embelon/SKY130_OpAmp/01_IdeaDesign/opamp_cascode_sym.png

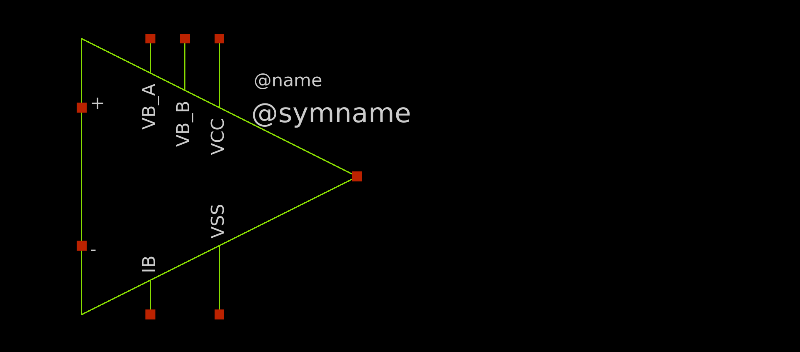
01_IdeaDesign/opamp_cascode_sym.png
