embelon/SKY130_OpAmp/01_IdeaDesign/opamp_cascode_sch.pdf

# /home/zwierzak/projects/SKY130_OpAmp/01_IdeaDesign/opamp_cascode.sch

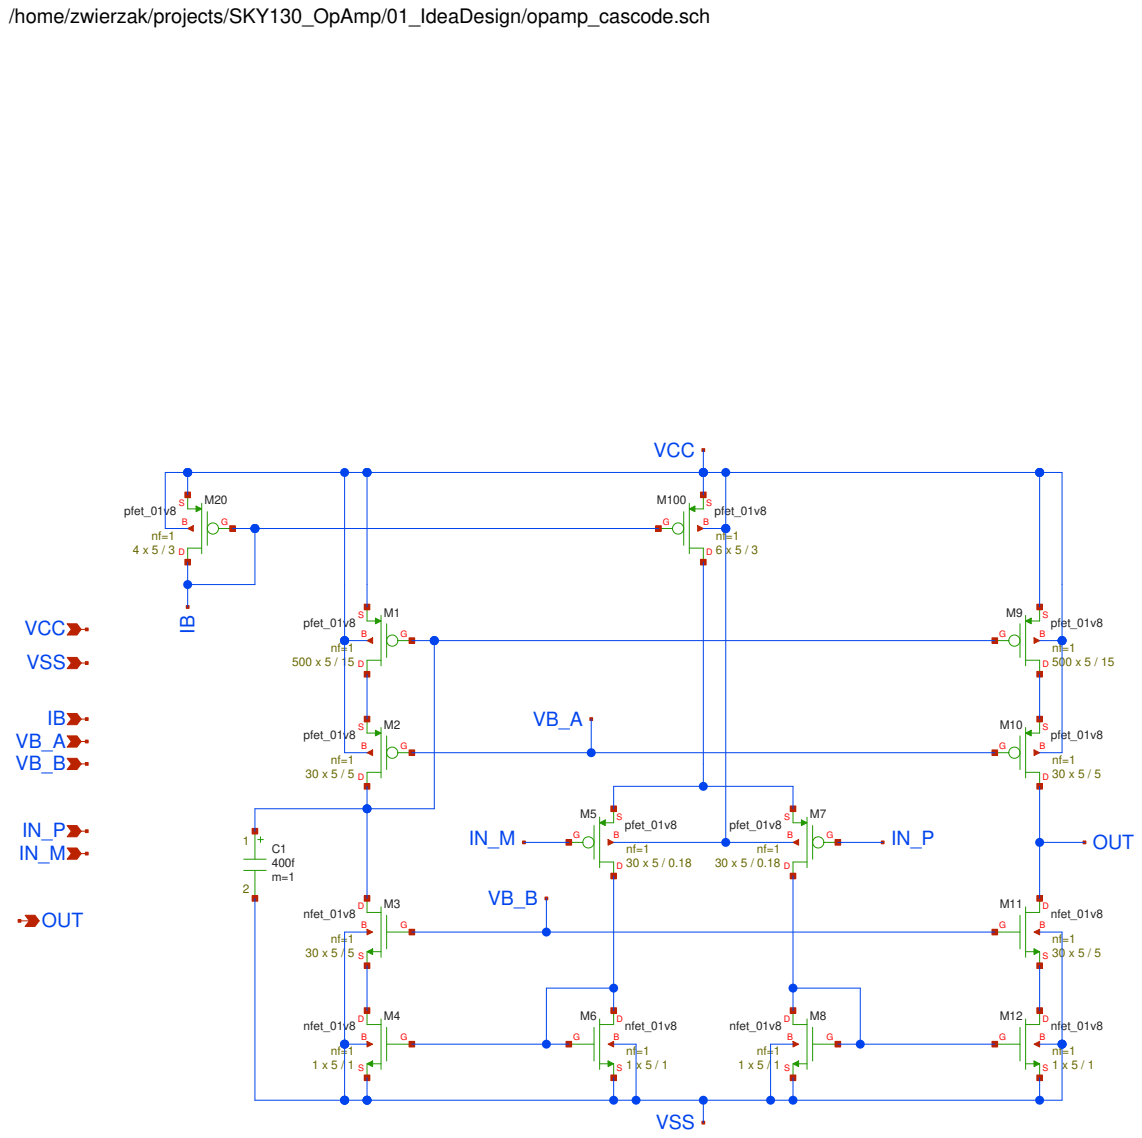
[picture p2: page 1]
VCC; VSS; IN_PIN_M; OUT; pfet_01v8; nfet_01v8
