embelon/SKY130_OpAmp/03_Layout/opamp_cascode_sch.pdf

# /home/zwierzak/projects/SKY130_OpAmp/03_Layout/opamp_cascode.sch

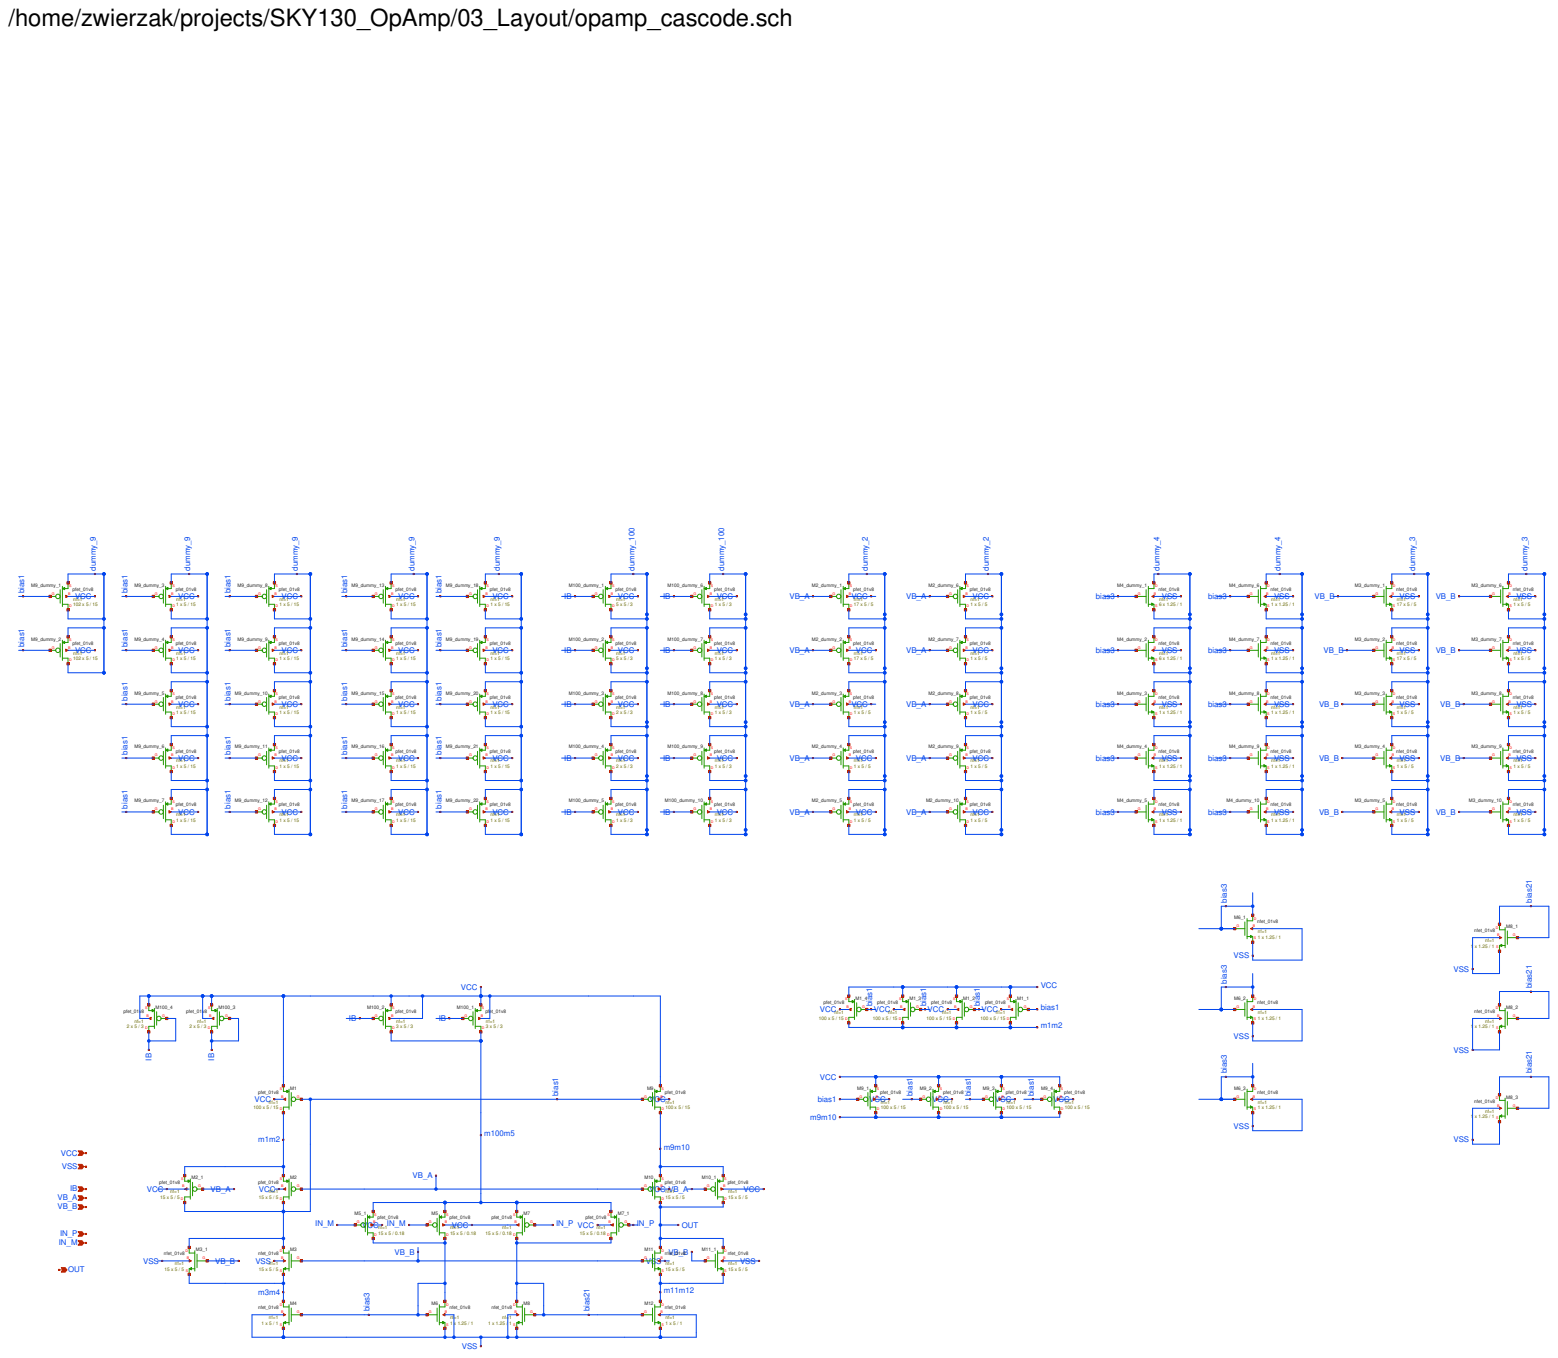
[picture p3: page 1]
VCC; VSS; IN_PIN_M; OUT; bias3; bias21; bias1; VB_AVB_A; bias1bias1; bias1bias1bias1bias1bias1; dummy_9; dummy_100; dummy_2; dummy_4; dummy_3; VSSVSS; VCCVCCVCCVCC; VCCVCC; pfet_01v8; nfet_01v8; M9_dummy_1; M9_dummy_2; M9_dummy_3; M9_dummy_4; M9_dummy_5; M9_dummy_6; M9_dummy_7; M9_dummy_8; M9_dummy_9; M9_dummy_10; M9_dummy_11; M9_dummy_12; M100_dummy_1; M100_dummy_2; M100_dummy_3; M100_dummy_4; M100_dummy_5; M100_dummy_6; M100_dummy_7; M100_dummy_8; M100_dummy_9; M100_dummy_10; M2_dummy_1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
