embelon/SKY130_OpAmp/06_ParasiticsSim/opamp_cascode.spice

* NGSPICE file created from opamp_cascode.ext - technology: sky130A

.subckt opamp_cascode IN_P IN_M VCC VSS OUT VB_A VB_B IB
X0 m9m10.t499 bias1.t0 VCC.t1023 VCC.t121 sky130_fd_pr__pfet_01v8 ad=0 pd=0 as=0 ps=0 w=5 l=15
**devattr s=58000,2116 d=58000,2116
X1 VCC.t1022 bias1.t1 m1m2.t499 VCC.t95 sky130_fd_pr__pfet_01v8 ad=0 pd=0 as=0 ps=0 w=5 l=15
**devattr s=58000,2116 d=58000,2116
X2 m3m4.t29 VB_B.t0 bias1 VSS.t4 sky130_fd_pr__nfet_01v8 ad=0 pd=0 as=1.45 ps=10.6 w=5 l=5
**devattr s=58000,2116 d=58000,2116
X3 dummy_9.t447 bias1.t2 dummy_9.t446 VCC.t33 sky130_fd_pr__pfet_01v8 ad=0 pd=0 as=0 ps=0 w=5 l=15
**devattr d=58000,2116
X4 VCC.t1021 bias1.t3 m1m2.t498 VCC.t17 sky130_fd_pr__pfet_01v8 ad=0 pd=0 as=0 ps=0 w=5 l=15
**devattr s=58000,2116 d=58000,2116
X5 dummy_9.t445 bias1.t4 dummy_9.t444 VCC.t30 sky130_fd_pr__pfet_01v8 ad=0 pd=0 as=0 ps=0 w=5 l=15
**devattr d=58000,2116
X6 VCC.t1020 bias1.t5 m1m2.t497 VCC.t95 sky130_fd_pr__pfet_01v8 ad=0 pd=0 as=0 ps=0 w=5 l=15
**devattr s=58000,2116 d=58000,2116
X7 m9m10.t498 bias1.t6 VCC.t1019 VCC.t11 sky130_fd_pr__pfet_01v8 ad=0 pd=0 as=0 ps=0 w=5 l=15
**devattr s=58000,2116 d=58000,2116
X8 dummy_9.t443 bias1.t7 dummy_9.t442 VCC.t33 sky130_fd_pr__pfet_01v8 ad=0 pd=0 as=0 ps=0 w=5 l=15
**devattr d=58000,2116
X9 m9m10.t497 bias1.t8 VCC.t1018 VCC.t21 sky130_fd_pr__pfet_01v8 ad=0 pd=0 as=0 ps=0 w=5 l=15
**devattr s=58000,2116 d=58000,2116
X10 dummy_4.t39 bias3.t38 dummy_4.t38 VSS.t6 sky130_fd_pr__nfet_01v8 ad=0 pd=0 as=0 ps=0 w=1.25 l=1
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
**devattr d=58000,2116
X225 dummy_2.t75 VB_A.t14 dummy_2.t74 VCC.t1043 sky130_fd_pr__pfet_01v8 ad=0 pd=0 as=0 ps=0 w=5 l=5
**devattr d=58000,2116
X226 m9m10.t416 bias1.t186 VCC.t874 VCC.t9 sky130_fd_pr__pfet_01v8 ad=0 pd=0 as=0 ps=0 w=5 l=15
**devattr s=58000,2116 d=58000,2116
X227 m9m10.t415 bias1.t187 VCC.t873 VCC.t21 sky130_fd_pr__pfet_01v8 ad=0 pd=0 as=0 ps=0 w=5 l=15
**devattr s=58000,2116 d=58000,2116
X228 OUT.t54 VB_A.t15 m9m10.t514 VCC.t1041 sky130_fd_pr__pfet_01v8 ad=0 pd=0 as=0 ps=0 w=5 l=5
**devattr s=58000,2116 d=58000,2116
X229 VCC.t872 bias1.t188 m1m2.t433 VCC.t44 sky130_fd_pr__pfet_01v8 ad=0 pd=0 as=0 ps=0 w=5 l=15
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
