embelon/SKY130_OpAmp/06_ParasiticsSim/simulation/opamp_cascode_op_power.spice

** sch_path: ../opamp_cascode_op_power.sch
**.subckt opamp_cascode_op_power
C1 out GND 1p m=1
I0 IBIAS GND 45u
x1 Vp Vn VCC GND out VB_A VB_B IBIAS opamp_cascode
**** begin user architecture code


Vsupply VCC GND 1.8
VbiasA VB_A GND 0.2
VbiasB VB_B GND 1.1
Vpos Vp GND 0.9
Vneg Vn GND 0.9
.include ../opamp_cascode.spice
.control
  define Power(x,y) -(x*y)
  save all
  op
  print Power(v(VCC), Vsupply#branch)
.endc



.param mc_mm_switch=1
.param mc_pr_switch=0
.include ~/.volare/sky130A/libs.tech/ngspice/corners/tt.spice
.include ~/.volare/sky130A/libs.tech/ngspice/r+c/res_typical__cap_typical.spice
.include ~/.volare/sky130A/libs.tech/ngspice/r+c/res_typical__cap_typical__lin.spice
.include ~/.volare/sky130A/libs.tech/ngspice/corners/tt/specialized_cells.spice

**** end user architecture code
**.ends
.GLOBAL GND
.end
