embelon/SKY130_OpAmp/(commit log)

2023-04-12 Adding files for version w/out LVT P-channel transistors in diff pair
    [opamp_noplvt.sch, test_ac_noplvt.sch, test_dc_response_noplvt.sch]
2023-05-22 Removed version with SVT PMOS transistors.
    [opamp_noplvt.sch, test_ac_noplvt.sch, test_dc_response_noplvt.sch]
2023-05-22 Changed all PMOS and NMOS transistors from LVT to SVT.
    [opamp.sch]
2023-05-22 Removed old AC open loop simulation and get correct one working (Ochoa Z-method)
    [opamp_test_ac.sch, test_ac.sch]
2023-05-22 Added (Folded) Cascode OpAmp and it's symbol.
    [opamp_cascode.sch]
2023-05-22 Added AC open look simulation for cascode OpAmp (acc. Ochoa Z-method).
    [opamp_cascode_test_ac.sch]
2023-05-23 Set biasing voltages to something better than VSS and VCC.
    [opamp_cascode.sch, opamp_cascode_test_ac.sch]
2023-05-23 Added simulation for dc response for cascode OpAmp.
    [opamp_cascode_dc_response.sch]
2023-05-31 Renamed components.
    [opamp_cascode.sch]
2023-05-31 Changed simulation settings to make ngspice plot results.
    [opamp_cascode_dc_response.sch]
2023-06-15 Changed span to +/-5mV for dc response simulation.
    [opamp_cascode_dc_response.sch]
2023-06-15 Removed unused labels.
    [opamp_cascode.sch]
2023-06-15 Added operation point simulation to check vds voltages across transistors.
    [opamp_cascode_op_point.sch]
2023-06-16 Adjusted transistors W/L to get better operation point.
    [opamp_cascode.sch]
2023-06-16 Proper way of checking max open loop gain.
    [opamp_cascode_dc_sweep_10mV.sch]
2023-06-16 Removed old way of checking max open loop gain.
    [opamp_cascode_dc_response.sch]
2023-06-16 Removing old files and adding view of current state of max open loop gain.
2023-06-16 Renamed file.
    [opamp_cascode_dc_max_gain.sch]
2023-06-16 Removed old 5/6T OpAmp files.
    [opamp.sch, opamp_test_ac.sch, test.sch, test_bias.sch]
2023-06-22 Updated transistors parameters.
    [opamp_cascode.sch, opamp_cascode_dc_max_gain.sch, opamp_cascode_test_ac.sch]
2023-06-23 Updated parameters. Max gain now at 18k, phase margin >60deg.
    [opamp_cascode.sch, opamp_cascode_op_point.sch]
2023-06-23 Renamed AC test to indicate method name.
    [opamp_cascode_ac_ochoa.sch]
2023-06-23 Made bias voltages and current accessible outside OpAmp.
    [opamp_cascode.sch, opamp_cascode_ac_ochoa.sch]
2023-06-26 Updated DC max gain and operation point simulations after making voltage and current biases accessible from outside of model.
    [opamp_cascode_dc_max_gain.sch, opamp_cascode_op_point.sch]
2023-06-26 Added open loop simulation.
    [opamp_cascode_ac_openloop.sch]
2023-06-27 Fixed inverted polarity of inputs.
    [opamp_cascode.sch]
2023-06-27 Added cimulation for bandwidth calculation.
    [opamp_cascode_ac_bandwidth.sch]
2023-06-27 Added measuring max openloop gain.
    [opamp_cascode_dc_max_gain.sch]
2023-06-30 Changed Vbias_B to 1.0V - max gain is now almost 32k.
    [opamp_cascode_ac_bandwidth.sch, opamp_cascode_ac_ochoa.sch, opamp_cascode_dc_max_gain.sch, opamp_cascode_op_point.sch]
2023-06-30 Updated simulations.
    [opamp_cascode_ac_bandwidth.sch, opamp_cascode_ac_openloop.sch, opamp_cascode_dc_max_gain.sch]
2023-07-04 Improved AC openloop, but still worse than with Ochoa Z-method.
    [opamp_cascode_ac_ochoa.sch, opamp_cascode_ac_openloop.sch]
2023-07-04 Added Id to op analysis.
    [opamp_cascode_op_point.sch]
2023-07-10 21M 63 79.8k v/v (#1)
    * 24.2M 75 63k v/v
    * 21M 66 79.8k v/v
    [opamp_cascode.sch, opamp_cascode_ac_bandwidth.sch, opamp_cascode_ac_ochoa.sch, opamp_cascode_dc_max_gain.sch, opamp_cascode_op_point.sch, opamp_cascode_test.sch]
2023-07-17 Modified testbenches to use in-code specified voltage sources instead of instantiated.
    [opamp_cascode_ac_bandwidth.sch, opamp_cascode_ac_ochoa.sch, opamp_cascode_ac_openloop.sch, opamp_cascode_dc_max_gain.sch, opamp_cascode_op_point.sch]
2023-07-17 Added tb to measure input referred noise.
    [opamp_cascode_ac_noise.sch]
2023-07-17 Added tb to measure PSRR.
    [opamp_cascode_ac_psrr.sch]
2023-07-17 Added tb to measure static power.
    [opamp_cascode_op_power.sch]
2023-08-21 Decreased Ibias to 4.5u
    [opamp_cascode_ac_openloop.sch]
2023-08-21 Removed unnecessary show command
    [opamp_cascode_op_power.sch]
2023-08-21 Added Monte CArlo simulation for dc max gain
    [opamp_cascode_dc_max_gain_mc.sch]
2023-09-06 Changed parameters in current mirror to move to higher value of Ibias to stay away from leakage current on IO pad.
    [opamp_cascode.sch]
2023-09-06 Adjusted Ibias to 45uA. Changed name of result SVG file.
    [opamp_cascode_dc_max_gain.sch]
2023-09-06 Adjusted Ibias to 45uA. Changed name of result SVG file and names of txt results files.
    [opamp_cascode_dc_max_gain_mc.sch]
2023-09-18 Increased value of Ibias after changing current mirror transistors.
    [opamp_cascode_ac_bandwidth.sch, opamp_cascode_ac_noise.sch, opamp_cascode_ac_ochoa.sch, opamp_cascode_ac_openloop.sch, opamp_cascode_ac_psrr.sch, opamp_cascode_op_power.sch]
2023-09-18 Decreased precision to speed up simulation.
    [opamp_cascode_dc_max_gain.sch]
2023-09-18 Fixed biasing voltages and current.
    [opamp_cascode_op_point.sch]
2023-09-18 Added simulation for CMRR measurement.
    [opamp_cascode_ac_cmrr.sch]
2023-09-18 Added circuit for Vos simulation.
    [opamp_cascode_op_vos.sch]
2023-10-08 Connecting each transistor Bulk to VCC (pfet) or GND (nfet) instead of tying to Sources.
    [opamp_cascode.sch]
2023-10-08 Adjusted max gain simulations.
    [opamp_cascode_dc_max_gain.sch, opamp_cascode_dc_max_gain_mc.sch]
2023-10-08 Changed absolute to relative paths in all simulation schematics.
    [opamp_cascode_ac_bandwidth.sch, opamp_cascode_ac_cmrr.sch, opamp_cascode_ac_noise.sch, opamp_cascode_ac_ochoa.sch, opamp_cascode_ac_openloop.sch, opamp_cascode_ac_psrr.sch, opamp_cascode_dc_max_gain.sch, opamp_cascode_dc_max_gain_mc.sch]
2023-10-08 Structurized project to include layout and post layout simulations also.
    [opamp_cascode.sch, opamp_cascode_ac_bandwidth.sch, opamp_cascode_ac_cmrr.sch, opamp_cascode_ac_noise.sch, opamp_cascode_ac_ochoa.sch, opamp_cascode_ac_openloop.sch, opamp_cascode_ac_psrr.sch, opamp_cascode_dc_max_gain.sch]
2023-10-09 Removed old test file.
    [opamp_cascode_test.sch]
2023-10-14 Fixed invalid path to sym file.
    [opamp_cascode_ac_cmrr.sch, opamp_cascode_ac_noise.sch, opamp_cascode_ac_ochoa.sch, opamp_cascode_ac_openloop.sch, opamp_cascode_ac_psrr.sch, opamp_cascode_dc_max_gain.sch, opamp_cascode_dc_max_gain_mc.sch, opamp_cascode_op_point.sch]
2023-10-26 Removed dummy transistors from differenetial input pair.
    [opamp_cascode.sch]
2023-10-31 Simplified MonteCarlo simulation.
    [opamp_cascode_dc_max_gain_mc.sch]
2023-10-31 Added MonteCarlo simulation for AC bandwidth.
    [opamp_cascode_ac_bandwidth_mc.sch]
2023-10-31 Added MonteCarlo simulation for Ochoa Z-method
    [opamp_cascode_ac_ochoa_mc.sch]
2023-11-01 Made vertical power bars longer.
2023-11-21 Adjusted C threshold to infinite to exclude parasitic capacitances
2023-11-22 Changed a way spice netlist with parasitics extraction is generated and tests with parasitics included are run now.
    [opamp_cascode_ac_bandwidth.sch, opamp_cascode_ac_bandwidth_mc.sch, opamp_cascode_ac_cmrr.sch, opamp_cascode_ac_noise.sch, opamp_cascode_ac_ochoa.sch, opamp_cascode_ac_ochoa_mc.sch, opamp_cascode_ac_openloop.sch, opamp_cascode_ac_psrr.sch]
2023-11-22 Fixed issue with parasitic resistances not included in spice
2023-11-26 Added PDF and SVG files for schematics.
2023-11-26 Update README.md with more description and schematics
2023-11-28 Added better naming to nets to make checking voltages during simulation easier.
    [opamp_cascode.sch]
2023-11-28 Fixed pin numbering to be in tact with spice netlist extracted from Magic
2023-11-28 Fixed issues with absolute paths in spice netlists and Xschem sch files, changed to relative now
    [opamp_cascode_ac_bandwidth.sch, opamp_cascode_ac_bandwidth_mc.sch, opamp_cascode_ac_cmrr.sch, opamp_cascode_ac_noise.sch, opamp_cascode_ac_ochoa.sch, opamp_cascode_ac_ochoa_mc.sch, opamp_cascode_ac_openloop.sch, opamp_cascode_ac_psrr.sch]
2023-11-28 Decreased sweep range and step for max gain simulation.
    [opamp_cascode_dc_max_gain.sch]
